fpvengineer/fun-hog/battery.dxf

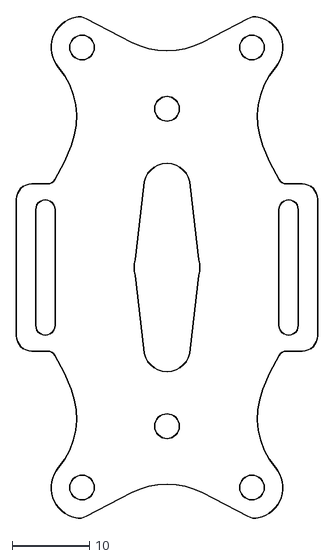
[picture p4: CAD file, 2018-07-02]
battery.dxf
39.0 x 65.0
