fpvengineer/fun-hog/2in-arm.dxf

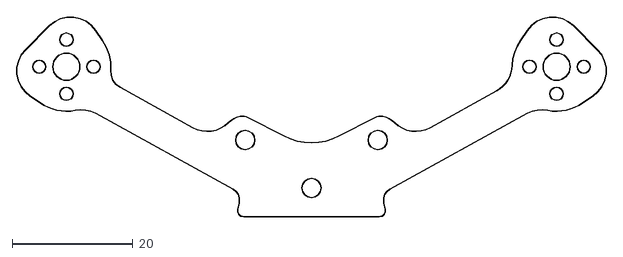
[picture p5: CAD file, 2018-07-02]
2in-arm.dxf
98.0 x 33.2
