fpvengineer/fun-hog/base-top.dxf

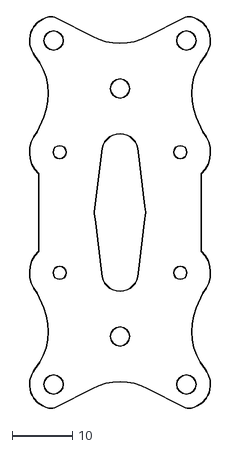
[picture p6: CAD file, 2018-07-02]
base-top.dxf
31.0 x 65.0
