fpvengineer/fun-hog/2.5in-arm.dxf

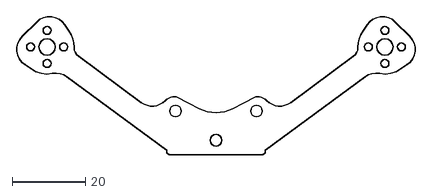
[picture p7: CAD file, 2018-07-02]
2.5in-arm.dxf
108.6 x 37.7
